BarmaleyPCB/Analog_Night_Light/HARDWAY.md

# Hardware Prototype
В этом файле я сначала покажу свою макетную плату и большую часть TP, а потом собранную печатную плату. Сразу скажу, что я держался кабель менеджменту : использовал красные и чёрные провода как силовые, определённые провода которые показывают определённый сигнал... Но провода нужных цветов просто закончились. По этому заранее прошу прощения у эстетов
## Макетная плата
Про [симуляцию](Simulation.md) и [топологию](PCB%20Design.md) печатной платы я ничего говорить не буду так как уже описал их в других файлах. 
### Блоки
Краткое напоминание TP :
| Test-point | Сигнал |
|:---|:---|
| TP1 | Выход датчика темноты |
| TP2 | Выход RC-цепи |
| TP3 | Выход датчика AM312 |
| TP4 | +5 |
| TP5 | Пилообразный сигнал |
| TP6 | Затвор MOSFET |
## Макетная плата
Вот сама макетная плата и "куст" из проводов
0c96d938-aee6-4802-9a00-018a0de24985
a3ad4d92-b805-4206-bd23-61680e0facb8
2957231d-a6b4-41a8-9f16-cd539f25e01c
f796b7ca-c7d2-4cb0-b45b-eba0343b1b2c

## Силовая часть 
На лабораторном блоке питания выставляем следующие характеристики : 12 V, 0.1 A

c81ee30f-a627-42d7-969d-8e8f30e27dd9

При 12 входящих Вольт на выходе LM317 получаем 5.2 V ( показания с Вольтметра взяты не с выхода LM317, а выведены отдельным проводом на макетной плате )
5206265d-a252-4a2f-9a39-10dff1d5b974
## AM312
Работает максимально просто : есть движение на выходе сигнал высокого уровня 3.3 V
9865d84b-59c1-4907-afe2-6a82da75c454

https://github.com/user-attachments/assets/ed6206b0-8b9e-4b82-a8dd-8758b66b2553
## Генератор пилообразных сигналов
13fd9d1d-04b9-4110-89f1-3739e7068539
058eaf05-7bde-44a3-94d8-14d190c59fe4

## Светодиодная лента
Светодиодная лента короткая, но я думаю больше одного метра в этом устройстве не пригодится

Фото светодиодной ленты и показания с лабораторного блока питания при свечении светодиодной ленты
15da9e50-62af-43cd-a03f-d77c420215b1
9df0a628-0125-49e9-bfef-76b5a593ef13

Вообще ограничение я ставил 150 мА, но когда игрался с ограничением по току не стал менять со 100 мА

## Коммутация

https://github.com/user-attachments/assets/e4a824a5-5326-4761-bd0c-d3a4cc7636f6

### Собранная печатная плата
Вот и долгожданная плата. Перед описанием хочу добавить, что плата ехала чуть больше месяца. Это не проблема самого PCBpi так как само производство печатной платы ( аудит, производство, контроль импеданса ) заняло чуть меньше 2-х недель, плата ехала с таможни практически месяц. А так сама плата выглядит очень достойно : маска качественная, переходные отверстия закрыты аккуратно и так же качественно. Единственный обидный косяк я забыл скинуть файлы маски... Маской были закрыты все пады и пришлось аккуратно счищать маску скальпелем. 


## Cнятая маска



## Собранная плата сверху и снизу




### Снятие сигналов с Тест - поинтов

Снятие значений происходит с выставленными 1/V и 1/S. Так что обращайте внимание на развёртку осцилографа
## TP1

Снятие сигнала с выхода Датчика темноты



Подстройка порога срабатывания происходит с помощью потенциометра в центре. Для теста сделал порог срабатывания самым минимальным

## TP2

Снятие сигнала с выхода RC-цепи



## TP3

Снятие сигнала с выхода пироэлектрического датчика АМ312





## TP4

Снятие выходного сигнала с LM317



## TP5

Выход с генератора пилообразных сигналов




Мне очень нравится этот блок особенно какая красивая пила по итогу вышла.

## TP6

 ШИМ-Компоратор

https://github.com/user-attachments/assets/7b0deda1-3c4d-4122-befd-ddaa311a932d

## Демонстрация работы без сигналов

https://github.com/user-attachments/assets/0acb130c-9748-47a6-9404-83e3e99bafca

## Заключение

Проект успешно пройден по всем этапам: от симуляции в Multisim до сборки и отладки реального устройства на печатной плате. Полностью аналоговая схема (без единой строки кода) доказала свою работоспособность. Все ключевые блоки - датчики, логика, генератор пилы, ШИМ и силовой ключ — работают стабильно и согласованно.

Этот прототип стал отличным примером того, как классическая схемотехника решает задачи, для которых сегодня часто используют микроконтроллеры.

# Hardware Prototype

In this file I will first show my breadboard and most of the test points, and then the assembled PCB. Let me say right away that I tried to maintain cable management: I used red and black wires for power, and specific wires for specific signals... But the wires of the required colors simply ran out. So I apologize in advance to the aesthetes.

## Breadboard

I will not talk about the [simulation](Simulation.md) and [PCB layout](PCB%20Design.md), as I have already described them in other files.

### Blocks

A quick reminder of the test points:

| Test-point | Signal |
|:---|:---|
| TP1 | Darkness sensor output |
| TP2 | RC circuit output |
| TP3 | AM312 sensor output|
| TP4 | +5 |
| TP5 | RAMP signal |
| TP6 | MOSFET gate |

## Breadboard

Here is the breadboard itself and the "bush" of wires.

0c96d938-aee6-4802-9a00-018a0de24985

a3ad4d92-b805-4206-bd23-61680e0facb8

2957231d-a6b4-41a8-9f16-cd539f25e01c

f796b7ca-c7d2-4cb0-b45b-eba0343b1b2c

## Power Section

On the laboratory power supply we set the following parameters: 12 V, 0.1 A.

c81ee30f-a627-42d7-969d-8e8f30e27dd9

With 12 V at the input, the LM317 output gives 5.2 V (the voltmeter readings were not taken from the LM317 output, but from a separate wire on the breadboard).

5206265d-a252-4a2f-9a39-10dff1d5b974

## AM312

It works very simply: when motion is detected, the output is a high-level signal of 3.3 V.

9865d84b-59c1-4907-afe2-6a82da75c454

https://github.com/user-attachments/assets/ed6206b0-8b9e-4b82-a8dd-8758b66b2553

## Ramp Generator

13fd9d1d-04b9-4110-89f1-3739e7068539

058eaf05-7bde-44a3-94d8-14d190c59fe4

## LED Strip

The LED strip is short, but I think more than one meter will not be needed in this device.

Photo of the LED strip and readings from the laboratory power supply when the LED strip is lit.

15da9e50-62af-43cd-a03f-d77c420215b1

9df0a628-0125-49e9-bfef-76b5a593ef13

Actually, I set the current limit to 150 mA, but when I was playing with the current limit, I did not change it from 100 mA.

## Switching

https://github.com/user-attachments/assets/e4a824a5-5326-4761-bd0c-d3a4cc7636f6

### Assembled Printed Circuit Board
Here is the long-awaited board. Before describing it, I should mention that it took a little over a month to arrive. This wasn't an issue with PCBpi itself—the actual manufacturing process (including design review, production, and impedance control) took less than two weeks—but the board spent nearly a month clearing customs. That said, the board itself looks very impressive: the solder mask is high-quality, and the vias are covered neatly and professionally. The only unfortunate oversight was that I forgot to submit the solder mask files... As a result, all the pads ended up covered by the mask, and I had to carefully scrape it off using a scalpel. 

## Removed mask



## Assembled board top and bottom




### Capturing Signals from Test Points

Readings are taken with 1/V and 1/S settings applied. Therefore, pay attention to the oscilloscope's sweep settings.
## TP1

Capturing the signal from the output of the darkness sensor



The activation threshold is adjusted using the potentiometer located in the center. For the test, I set the trigger threshold to the minimum possible value.

## TP2

Signal acquisition from the output of the RC circuit



## TP3

Signal acquisition from the output of the AM312 pyroelectric sensor





## TP4

Signal acquisition from the output of the LM317



## TP5

Output of the sawtooth wave generator




I really like this block—especially how clean the resulting sawtooth wave turned out.

## TP6

PWM Comparator

https://github.com/user-attachments/assets/7b0deda1-3c4d-4122-befd-ddaa311a932d

## Demonstration of operation without input signals

https://github.com/user-attachments/assets/0acb130c-9748-47a6-9404-83e3e99bafca

## Conclusion

The project has been successfully completed through all its stages: from simulation in Multisim to the assembly and debugging of the actual device on a printed circuit board. The entirely analog circuit—containing not a single line of code—has proven to be fully functional. All key components—sensors, logic circuitry, the sawtooth wave generator, the PWM stage, and the power switch—operate reliably and in coordination.

This prototype serves as an excellent example of how classical circuit design can address tasks for which microcontrollers are frequently used today.
