BarmaleyPCB/Analog_Night_Light/(list of files, drawings)

Other design files:
full_circuit.ms14
light_sensor and_gate_rc.ms14
power_supply.ms14
pwm_comparator.ms14
ramp_generator.ms14
