BarmaleyPCB/Analog_Night_Light/(commit log)

2026-08-23 Power supply
    [Стабилизатор питания.ms14]
2026-08-23 RAMP signal
    [Генератор пилообразных сигналов.ms14]
2026-08-25 Create PCB Design.md
2026-08-25 Update PCB Design.md
2026-08-25 PCB Design.md
2026-08-25 Altium Designer/Gerber
